IndexAsm/USB_Hub/USB_Hub.kicad_pcb

## KiCad design USB_Hub.kicad_pcb (2026-10-09)

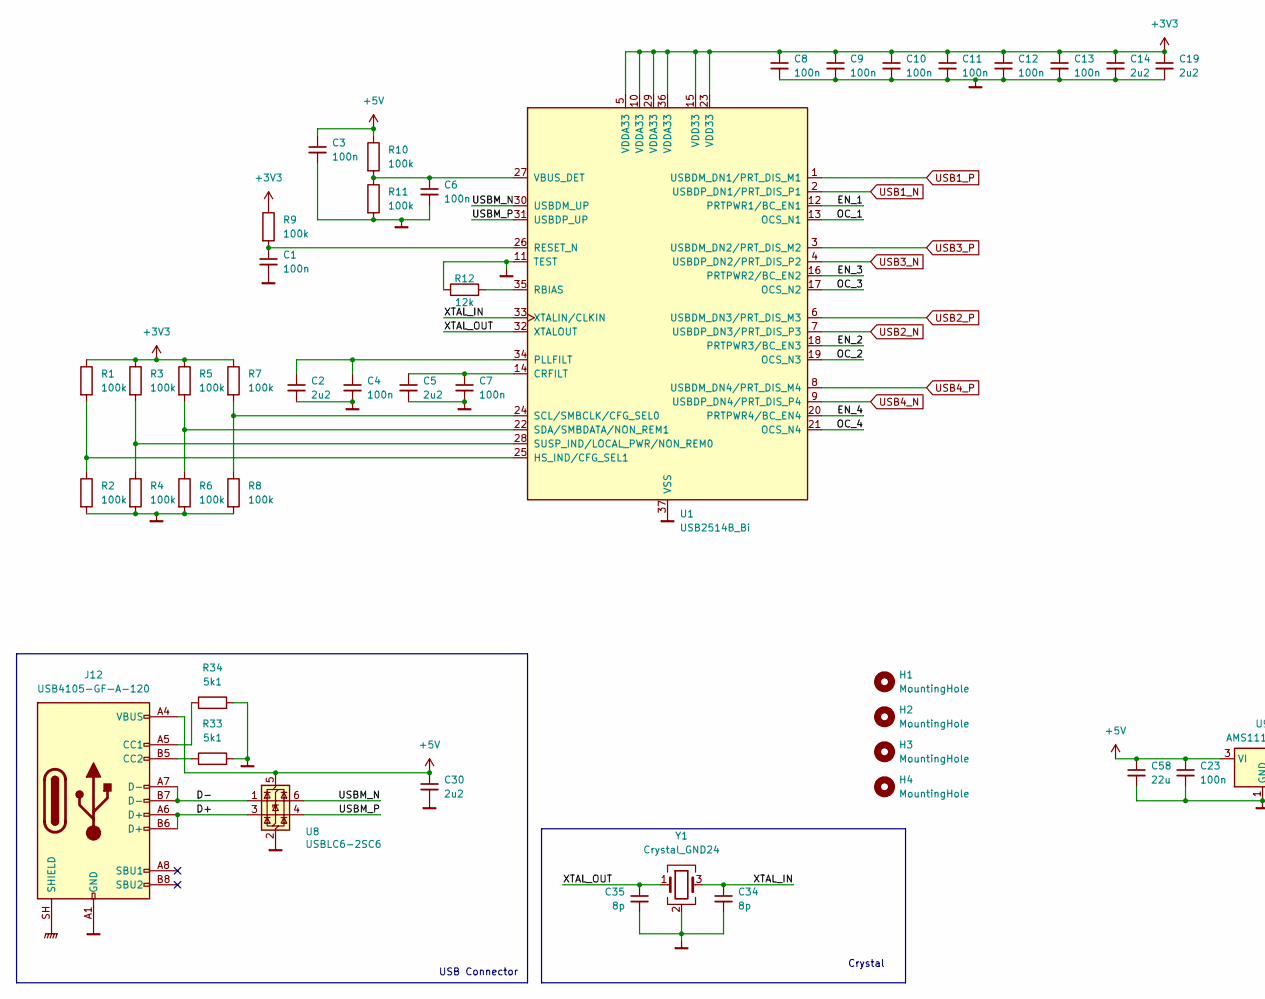
[picture p5: schematic USB_Hub.kicad_sch, part in row 1, column 1]

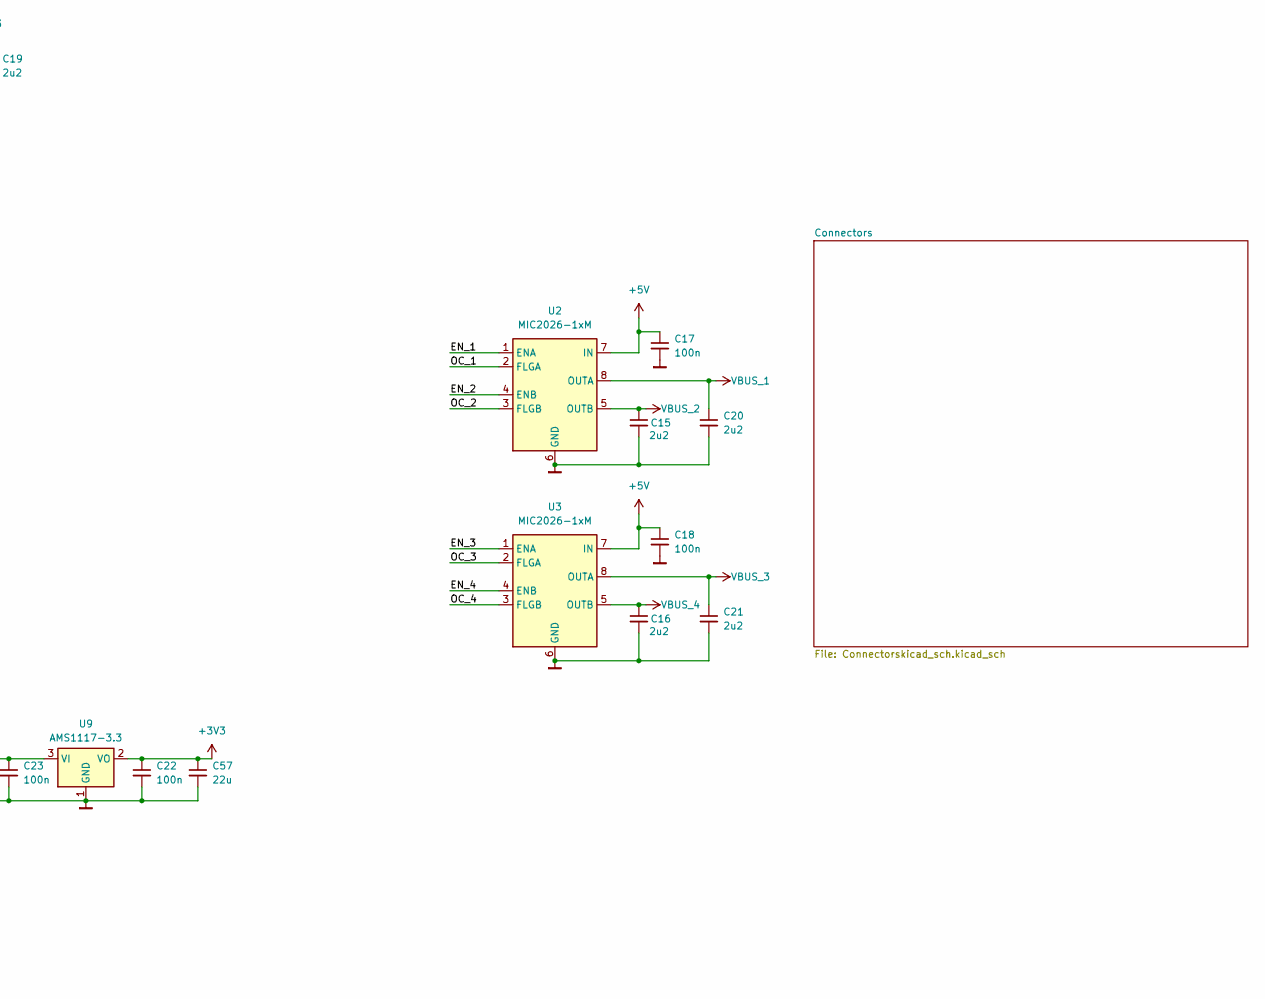
[picture p6: schematic USB_Hub.kicad_sch, part in row 1, column 2]

Parts:
C1, C3, C4, C6, C7, C8, C9, C10, C11, C12, C13, C17, C18, C22, C23: 100n; C_0603_1608Metric
C2, C5, C14, C15, C16, C19, C20, C21, C30: 2u2; C_0603_1608Metric
C34, C35: 8p; C_0603_1608Metric
C57, C58: 22u; C_1206_3216Metric
H1, H2, H3, H4: MountingHole; MountingHole_3.2mm_M3
J12: USB4105-GF-A-120; USB_C_Receptacle_G-Switch_GT-USB-7010ASV
R1, R2, R3, R4, R5, R6, R7, R8, R9, R10, R11: 100k; R_0603_1608Metric
R12: 12k; R_0603_1608Metric
R33, R34: 5k1; R_0603_1608Metric
U1: USB2514B_Bi; QFN-36-1EP_6x6mm_P0.5mm_EP3.7x3.7mm
U2, U3: MIC2026-1xM; SOIC-8_3.9x4.9mm_P1.27mm
U8: USBLC6-2SC6; SOT-23-6
U9: AMS1117-3.3; SOT-223-3_TabPin2
Y1: Crystal_GND24; Crystal_SMD_EuroQuartz_MT-4Pin_3.2x2.5mm

Connections:
+3V3: C8.1, C9.1, C10.1, C11.1, C12.1, C13.1, C14.1, C19.1, C22.1, C57.1, R1.1, R3.1, R5.1, R7.1, R9.1, U1.5 (VDDA33), U1.10 (VDDA33), U1.15 (VDD33), U1.23 (VDD33), U1.29 (VDDA33), U1.36 (VDDA33), U9.2 (VO)
+5V: C3.1, C17.1, C18.1, C23.1, C30.1, C58.1, J12.A4 (VBUS), J12.A9 (VBUS), J12.B4 (VBUS), J12.B9 (VBUS), R10.1, U2.7 (IN), U3.7 (IN), U8.5 (VBUS), U9.3 (VI)
/D+: J12.A6 (D+), J12.B6 (D+), U8.3 (I/O2)
/D-: J12.A7 (D-), J12.B7 (D-), U8.1 (I/O1)
/EN_1: U1.12 (PRTPWR1/BC_EN1), U2.1 (ENA)
/EN_2: U1.18 (PRTPWR3/BC_EN3), U2.4 (ENB)
/EN_3: U1.16 (PRTPWR2/BC_EN2), U3.1 (ENA)
/EN_4: U1.20 (PRTPWR4/BC_EN4), U3.4 (ENB)
/OC_1: U1.13 (OCS_N1), U2.2 (FLGA)
/OC_2: U1.19 (OCS_N3), U2.3 (FLGB)
/OC_3: U1.17 (OCS_N2), U3.2 (FLGA)
/OC_4: U1.21 (OCS_N4), U3.3 (FLGB)
/USBM_N: U1.30 (USBDM_UP), U8.6 (I/O1)
/USBM_P: U1.31 (USBDP_UP), U8.4 (I/O2)
/XTAL_IN: C34.1, U1.33 (XTALIN/CLKIN), Y1.3
/XTAL_OUT: C35.1, U1.32 (XTALOUT), Y1.1
GNDPWR: J12.SH (SHIELD); also elsewhere on the board
Masa: C1.2, C2.2, C3.2, C4.2, C5.2, C6.2, C7.2, C8.2, C9.2, C10.2, C11.2, C12.2, C13.2, C14.2, C15.2, C16.2, C17.2, C18.2, C19.2, C20.2, C21.2, C22.2, C23.2, C30.2, C34.2, C35.2, C57.2, C58.2, J12.A1 (GND), J12.A12 (GND), J12.B1 (GND), J12.B12 (GND), R2.2, R4.2, R6.2, R8.2, R11.2, R12.1, R33.2, R34.2, U1.11 (TEST), U1.37 (VSS), U2.6 (GND), U3.6 (GND), U8.2 (GND), U9.1 (GND), Y1.2 (G), Y1.4 (G); also elsewhere on the board
unnamed: J12.A5 (CC1), R34.1
unnamed: J12.B5 (CC2), R33.1
unnamed: C5.1, C7.1, U1.14 (CRFILT)
unnamed: R1.2, R2.1, U1.25 (HS_IND/CFG_SEL1)
unnamed: C2.1, C4.1, U1.34 (PLLFILT)
unnamed: R12.2, U1.35 (RBIAS)
unnamed: C1.1, R9.2, U1.26 (RESET_N)
unnamed: R7.2, R8.1, U1.24 (SCL/SMBCLK/CFG_SEL0)
unnamed: R5.2, R6.1, U1.22 (SDA/SMBDATA/NON_REM1)
unnamed: R3.2, R4.1, U1.28 (SUSP_IND/LOCAL_PWR/NON_REM0)
unnamed: C6.1, R10.2, R11.1, U1.27 (VBUS_DET)
USB1_N: U1.2 (USBDP_DN1/PRT_DIS_P1); also elsewhere on the board
USB1_P: U1.1 (USBDM_DN1/PRT_DIS_M1); also elsewhere on the board
USB2_N: U1.7 (USBDP_DN3/PRT_DIS_P3); also elsewhere on the board
USB2_P: U1.6 (USBDM_DN3/PRT_DIS_M3); also elsewhere on the board
USB3_N: U1.4 (USBDP_DN2/PRT_DIS_P2); also elsewhere on the board
USB3_P: U1.3 (USBDM_DN2/PRT_DIS_M2); also elsewhere on the board
USB4_N: U1.9 (USBDP_DN4/PRT_DIS_P4); also elsewhere on the board
USB4_P: U1.8 (USBDM_DN4/PRT_DIS_M4); also elsewhere on the board
VBUS_1: C20.1, U2.8 (OUTA); also elsewhere on the board
VBUS_2: C15.1, U2.5 (OUTB); also elsewhere on the board
VBUS_3: C21.1, U3.8 (OUTA); also elsewhere on the board
VBUS_4: C16.1, U3.5 (OUTB); also elsewhere on the board

Notes on the sheet:
USB Connector
Crystal

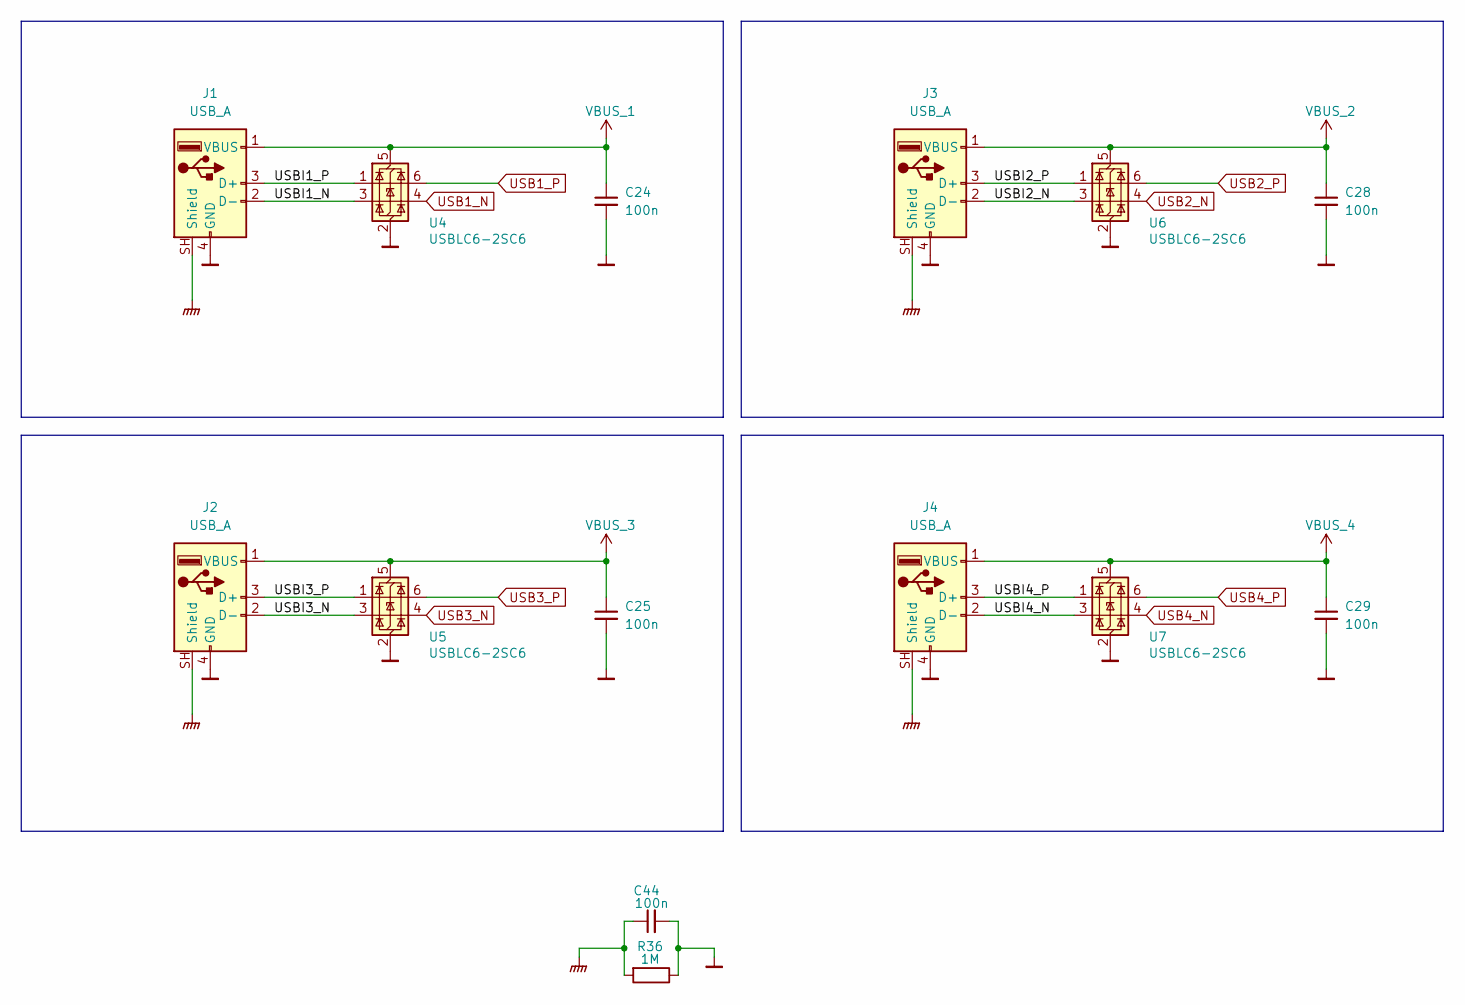
[picture p7: schematic Connectorskicad_sch.kicad_sch]

Parts:
C24, C25, C28, C29, C44: 100n; C_0603_1608Metric
J1, J2, J3, J4: USB_A; USB-A-S-X-X-VT
R36: 1M; R_0603_1608Metric
U4, U5, U6, U7: USBLC6-2SC6; SOT-23-6

Connections:
/Connectors/USBI1_N: J1.2 (D-), U4.3 (I/O2)
/Connectors/USBI1_P: J1.3 (D+), U4.1 (I/O1)
/Connectors/USBI2_N: J3.2 (D-), U6.3 (I/O2)
/Connectors/USBI2_P: J3.3 (D+), U6.1 (I/O1)
/Connectors/USBI3_N: J2.2 (D-), U5.3 (I/O2)
/Connectors/USBI3_P: J2.3 (D+), U5.1 (I/O1)
/Connectors/USBI4_N: J4.2 (D-), U7.3 (I/O2)
/Connectors/USBI4_P: J4.3 (D+), U7.1 (I/O1)
GNDPWR: C44.1, J1.SH (Shield), J2.SH (Shield), J3.SH (Shield), J4.SH (Shield), R36.2; also elsewhere on the board
Masa: C24.2, C25.2, C28.2, C29.2, C44.2, J1.4 (GND), J2.4 (GND), J3.4 (GND), J4.4 (GND), R36.1, U4.2 (GND), U5.2 (GND), U6.2 (GND), U7.2 (GND); also elsewhere on the board
USB1_N: U4.4 (I/O2); also elsewhere on the board
USB1_P: U4.6 (I/O1); also elsewhere on the board
USB2_N: U6.4 (I/O2); also elsewhere on the board
USB2_P: U6.6 (I/O1); also elsewhere on the board
USB3_N: U5.4 (I/O2); also elsewhere on the board
USB3_P: U5.6 (I/O1); also elsewhere on the board
USB4_N: U7.4 (I/O2); also elsewhere on the board
USB4_P: U7.6 (I/O1); also elsewhere on the board
VBUS_1: C24.1, J1.1 (VBUS), U4.5 (VBUS); also elsewhere on the board
VBUS_2: C28.1, J3.1 (VBUS), U6.5 (VBUS); also elsewhere on the board
VBUS_3: C25.1, J2.1 (VBUS), U5.5 (VBUS); also elsewhere on the board
VBUS_4: C29.1, J4.1 (VBUS), U7.5 (VBUS); also elsewhere on the board

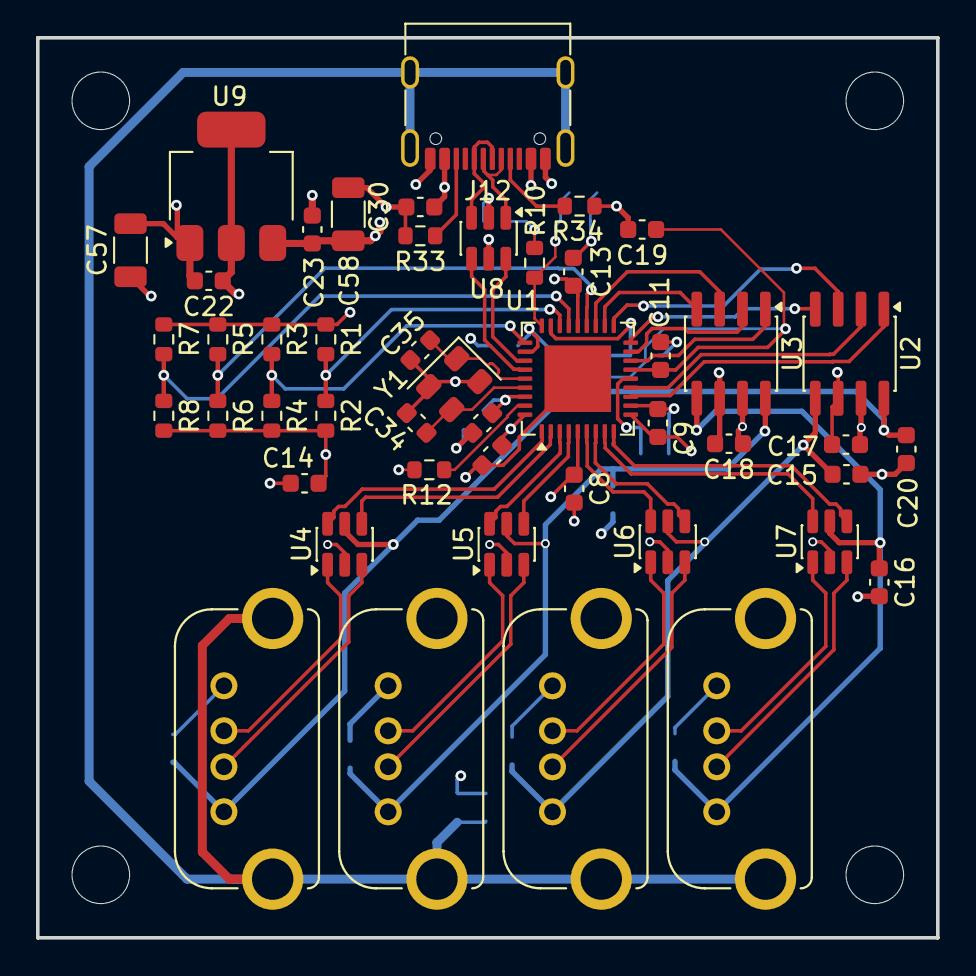
[picture p8: board USB_Hub.kicad_pcb from above]

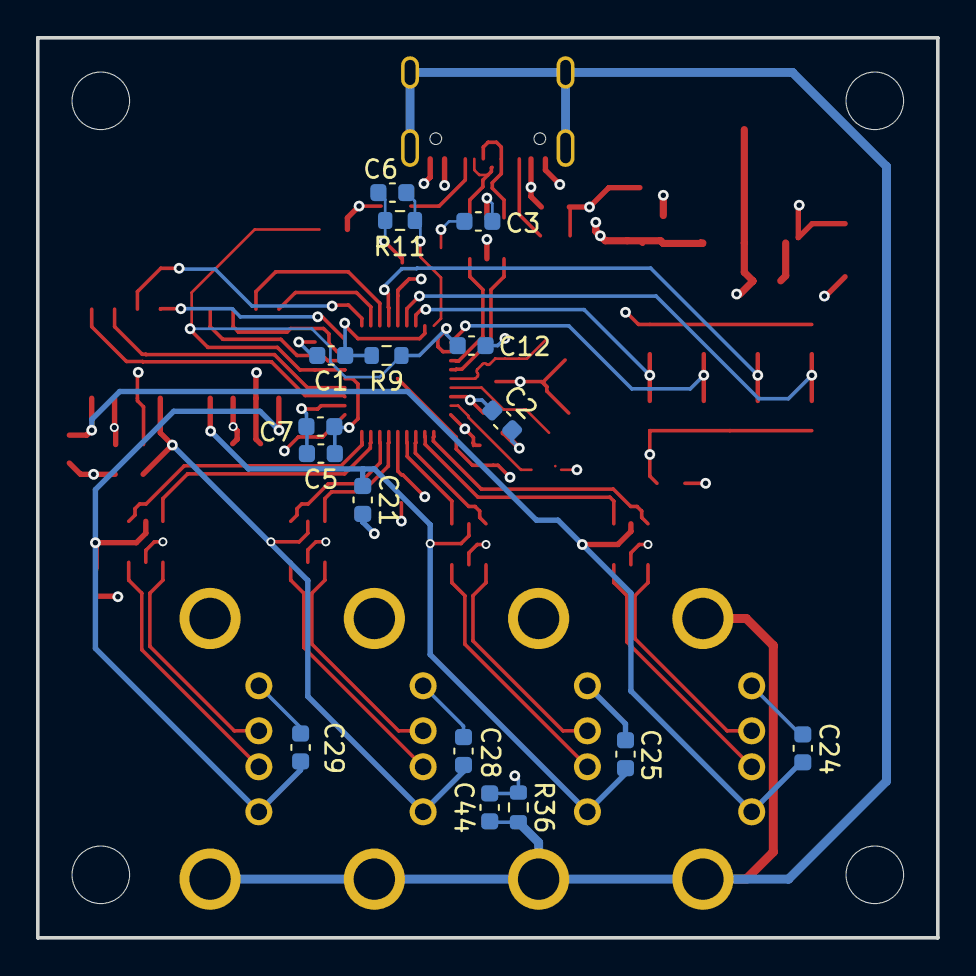
[picture p9: board USB_Hub.kicad_pcb from below]

Board: 4 copper layers, 50.0 x 50.0 mm, 67 parts (16 on the bottom side), 49 nets.
